Momen-Odeh/Braille-Printer-GP2/(commit log)

2023-08-21 add print string function
2023-08-22 finish print string function
2023-08-25 esp complete flow
2023-08-25 stable version of arduino code
